Jekyll-Dieleco/F103RCT6/B/PCB/1.0/F103RCT6.pdf

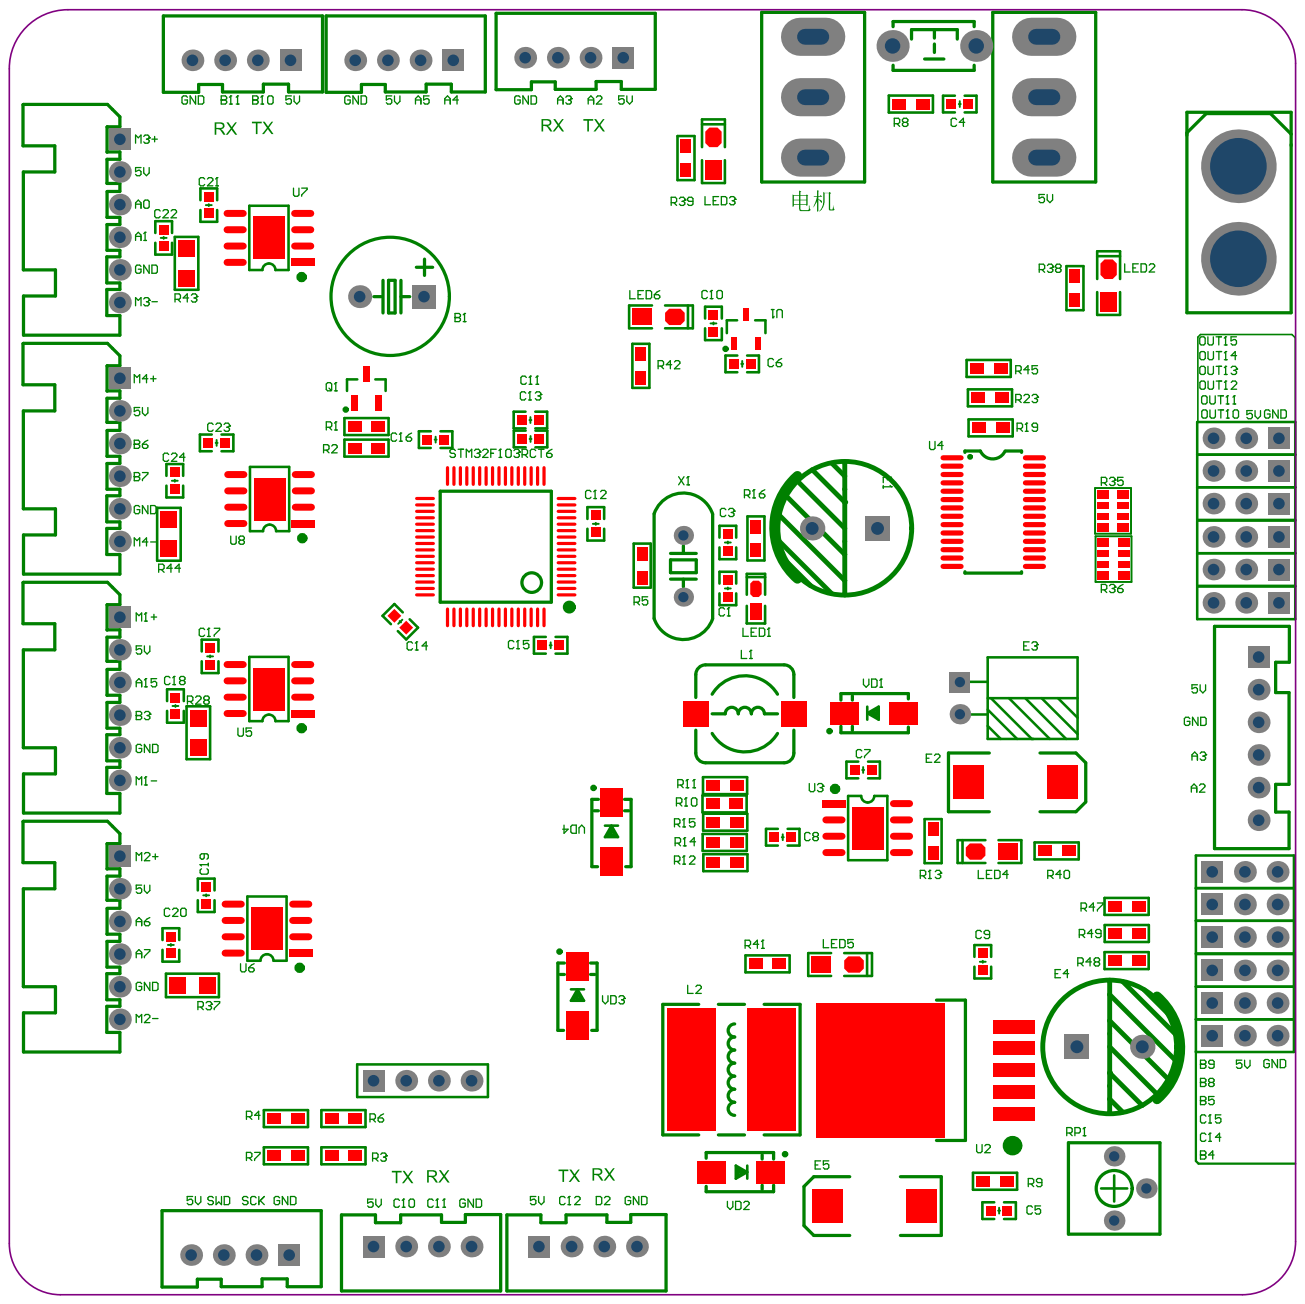
[picture p1: page 1]

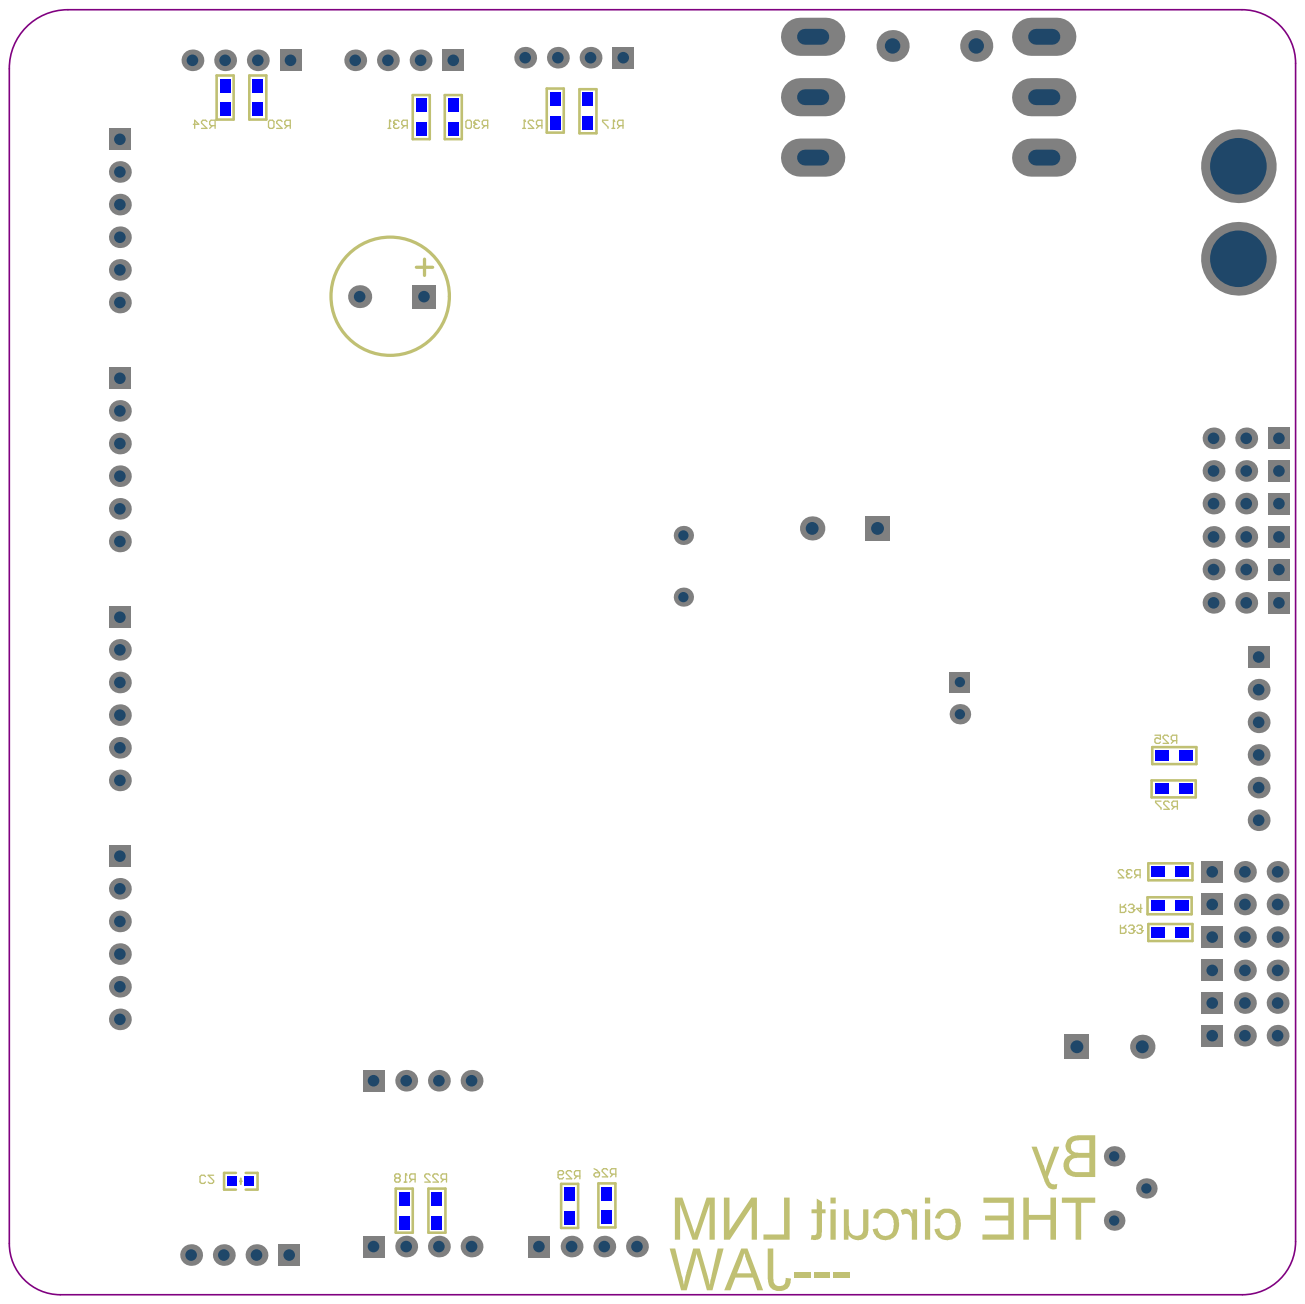
[picture p2: page 2]
