Jekyll-Dieleco/F103RCT6/B/PCB/1.0/RCT6.pdf

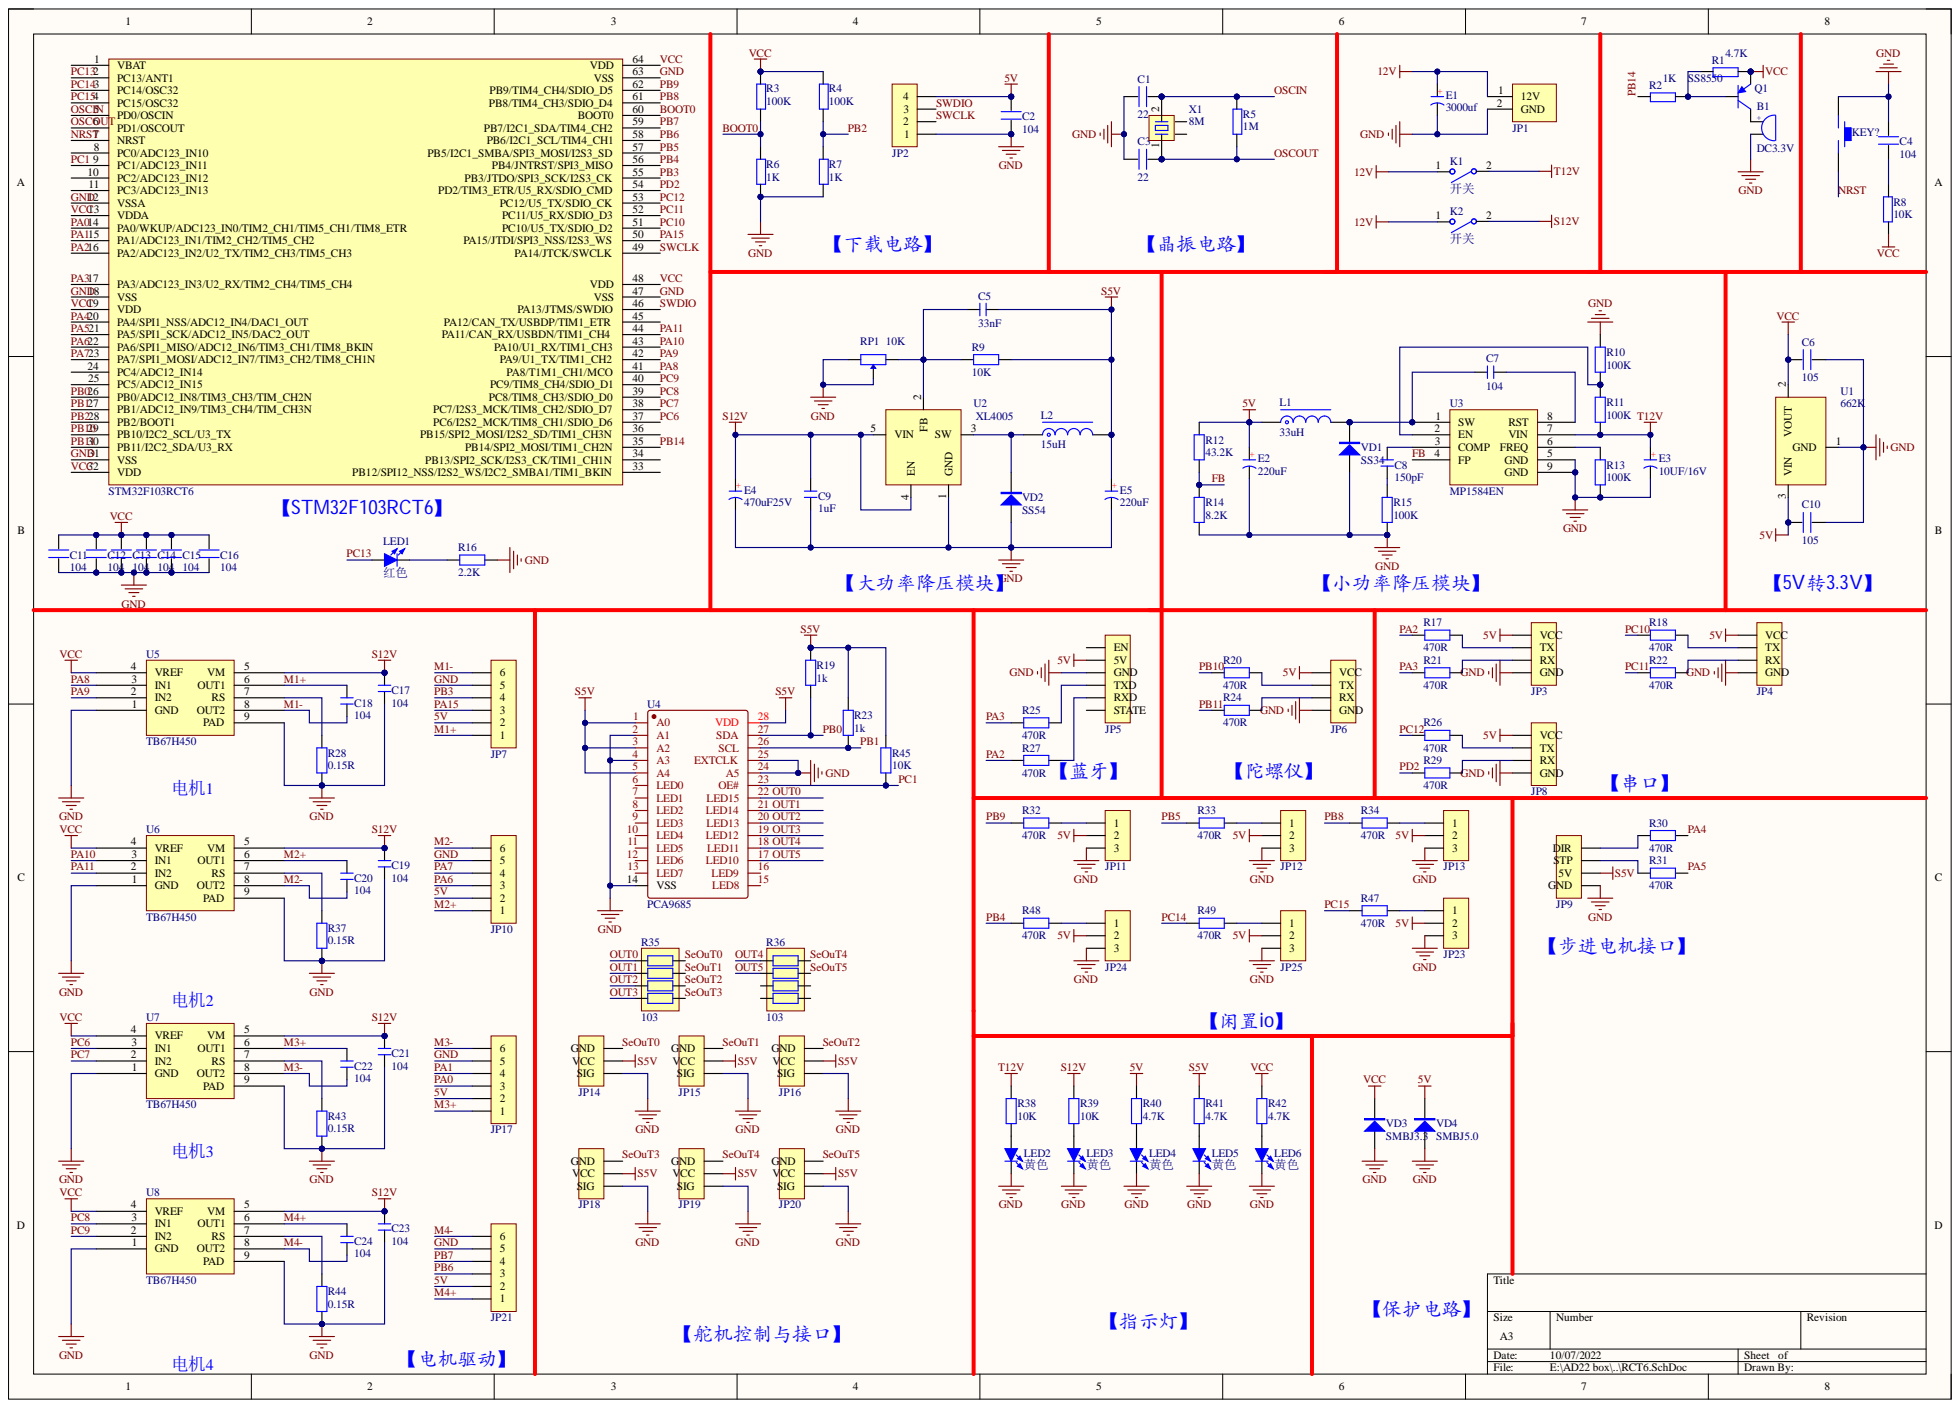
[picture p3: page 1]
