Jekyll-Dieleco/F103RCT6/(list of files, drawings)

Other design files:
B/PCB/1.0/F103RCT6主控板.PrjPcb
B/PCB/1.0/RCT6.SchDoc
B/PCB/2.0/F103RCT6主控板11.PrjPcb
B/PCB/2.0/RCT6.SchDoc
B/PCB/3.0/RCT6.SchDoc
