Jekyll-Dieleco/F103RCT6/(commit log)

2023-03-23 项目初始化
    [F103RCT6主控板.PrjPcb, RCT6.SchDoc]
2023-03-31 2.0和3.0版本迭代
    [F103RCT6.GBL, F103RCT6.GBO, F103RCT6.GBP, F103RCT6.GBS, F103RCT6.GKO, F103RCT6.GM1, F103RCT6.GTL, F103RCT6.GTO]
